cengizhantopcu53/hava_kalitesi_olcumu/Source/additional/hava_kalitesi_olcumu_sensor.xlsx

Sheet: SO2
SO2
Üretici | Sensör | Çıkış | Sıcaklık | Voltaj | Akım | Ölçüm | Basınç | Fiyat | Link
Kemet | USEQGCCAS82100 | Analog | -40°C - 85°C | 2.7V - 8V | - | 7.30µm / (200nm) | - | $99 | https://www.digikey.com/en/products/detail/kemet/USEQGCCAS82100/11503859
 | USEQGCDAS82100 | Analog | -40°C - 85°C | 2.7V - 8V | - | 7.30µm / (200nm) | - | $171 | https://www.digikey.com/en/products/detail/kemet/USEQGCDAS82100/12501736
SGX | EC4-20-SO2 | Voltaj | -20°C - 40°C | - | - | 0-20 ppm | 90-110 kP | $157 | https://www.digikey.com/en/products/detail/amphenol-sgx-sensortech/EC4-20-SO2/10270048
 | EC4-2000-SO2 | Voltaj | -20°C - 50°C | - | - | 0-2000 ppm | 90-110 kP | $134 | https://tr.farnell.com/amphenol-sgx-sensortech/ec4-2000-so2/industrial-sensor-so2-2000ppm/dp/3523152
 | PS1-SO2-50 | Voltaj | -40°C - 55°C | - | - | 0-50 ppm | 800 to 1200 hPA | $75 | https://www.mouser.com.tr/ProductDetail/Amphenol-SGX-Sensortech/PS1-SO2-50?qs=vvQtp7zwQdPTUdx7W%2F6Zdg%3D%3D
 | PS4-SO2-50 | Voltaj | -40°C - 55°C | - | - | 0-50 ppm | 800 to 1200 hPA | $142 | https://www.mouser.com.tr/ProductDetail/Amphenol-SGX-Sensortech/PS4-SO2-50?qs=vvQtp7zwQdOwl2xQY7f%2F%2Fw%3D%3D
 | SGX-4SO2 | Akım | -30°C - 50°C | 0.75V | 0.1 mA | 0-20 ppm | 800-1200 mbar | $95 | https://www.digikey.com/en/products/detail/amphenol-sgx-sensortech/SGX-4SO2/15816416
 | SGX-7SO2 | Akım | -30°C - 50°C | 0.75V | 0.1 mA | 0-100 ppm | 800-1200 mbar | $102 | https://www.digikey.com/en/products/detail/amphenol-sgx-sensortech/SGX-7SO2/15816406

Sheet: NO2
NO2
Üretici | Sensör | Çıkış | Sıcaklık | Voltaj | Akım | Ölçüm | Basınç | Fiyat | Link
Kemet | USEQGCDAN82100 | Analog | -40°C - 85°C | 2.7V - 8V | - | 6.20µm / (200nm) | - | $154 | https://www.digikey.com/en/products/detail/kemet/USEQGCDAN82100/12501745
SGX | EC4-20-NO2 | Voltaj | -20°C - 50°C | - | 0.4 µA | 0-20 ppm | 90-110 kPa | $159 | https://tr.farnell.com/amphenol-sgx-sensortech/ec4-20-no2/industrial-sensor-no2-20ppm-th/dp/3513412
 | PS1-NO2-50 | Voltaj | -40°C - 55°C | - | - | 0-50 ppm | 800-1200 kPa | $75 | https://www.digikey.com/en/products/detail/amphenol-sgx-sensortech/PS1-NO2-50/16634072
 | PS4-NO2-50 | Voltaj | -40°C - 55°C | - | - | 0-50 ppm | 800-1200 kPa | $142 | https://www.digikey.com/en/products/detail/amphenol-sgx-sensortech/PS4-NO2-50/16634084
 | MICS-2714 | Voltaj | -30°C - 85°C | 4.9V - 5.1V | 26 mA | 0.05-10 ppm | - | $11 | https://www.digikey.com/en/products/detail/amphenol-sgx-sensortech/MICS-2714/15816394
 | MICS-4514 | Voltaj | -30°C - 85°C | 4.9V - 5.1V | 26 mA | 0.05-10 ppm | - | $11 | https://www.digikey.com/en/products/detail/amphenol-sgx-sensortech/MICS-4514/15816409
 | SGX-7NO2 | Akım | -30°C - 50°C | 1.3 V | 0.3 mA | 0-20 ppm | 800 to 1200 mbar | $95 | https://www.digikey.com/en/products/detail/amphenol-sgx-sensortech/SGX-7NO2/15816354
 | SGX-4NO2 | Akım | -30°C - 50°C | 1.3 V | 0.3 mA | 0-20 ppm | 800 to 1200 mbar | $49 | https://www.digikey.com/en/products/detail/amphenol-sgx-sensortech/SGX-4NO2/15816430
 | SGX-4NO2-2E | Akım | -30°C - 50°C | 1.3 V | 0.3 mA | 0-20 ppm | 800 to 1200 mbar | $49 | https://www.digikey.com/en/products/detail/amphenol-sgx-sensortech/SGX-4NO2-2E/15816361

Sheet: CO
CO
Üretici | Sensör | Çıkış | Sıcaklık | Voltaj | Akım | Ölçüm | Basınç | Fiyat | Link
Kemet | USEQGCCAC8L100 | Analog | -40°C - 85°C | 2.7V - 8V | - | 4.64µm / (180nm) | - | $77 | https://www.digikey.com/en/products/detail/kemet/USEQGCCAC8L100/11503889
 | USEQGCCAC8N100 | Analog | -40°C - 85°C | 2.7V - 8V | - | 4.64µm / (90nm) | - | $77 | https://www.mouser.com.tr/ProductDetail/KEMET/USEQGCCAC8N100?qs=xZ%2FP%252Ba9zWqaz%252Bpt9JkTjvQ%3D%3D
 | USEQGCDAC8L100 | Analog | -40°C - 85°C | 2.7V - 8V | - | 4.64µm / (180nm) | - | $97 | https://www.digikey.com/en/products/detail/kemet/USEQGCDAC8L100/12501732
 | USEQGCDAC8N100 | Analog | -40°C - 85°C | 2.7V - 8V | - | 4.64µm / (90nm) | - | $97 | https://www.digikey.com/en/products/detail/kemet/USEQGCDAC8N100/12501743
SGX | EC4-500-CO | Voltaj | -20°C - 50°C | - | - | 0-500 ppm | 90-110 kPa | $98 | https://www.mouser.com.tr/ProductDetail/Amphenol-SGX-Sensortech/EC4-500-CO?qs=0lSvoLzn4L9J%2FbV1Ld8fdw%3D%3D
 | EC4-2000-CO | Voltaj | -20°C - 50°C | - | - | 0-2000 ppm | 90-110 kPa | $82 | https://tr.farnell.com/amphenol-sgx-sensortech/ec4-2000-co/electrochemical-sensor-co-2000ppm/dp/3513416
 | PS1-CO-100 | Voltaj | -40°C - 55°C | - | - | 0-100 ppm | 80-120 kPa | $58 | https://www.digikey.com/en/products/detail/amphenol-sgx-sensortech/PS1-CO-100/16634088
 | PS4-CO-100 | Voltaj | -40°C - 55°C | - | - | 0-100 ppm | 80-120 kPa | $116 | https://www.mouser.com.tr/ProductDetail/Amphenol-SGX-Sensortech/PS4-CO-100?qs=vvQtp7zwQdPEGqOtAoKNiQ%3D%3D
 | PS1-CO-1000 | Voltaj | -40°C - 55°C | - | - | 0-1000 ppm | 80-120 kPa | $45 | https://www.digikey.com/en/products/detail/amphenol-sgx-sensortech/PS1-CO-1000/16634062
 | PS4-CO-1000 | Voltaj | -40°C - 55°C | - | - | 0-1000 ppm | 80-120 kPa | $95 | https://www.mouser.com.tr/ProductDetail/Amphenol-SGX-Sensortech/PS4-CO-1000?qs=vvQtp7zwQdOtSaOt6WSp0g%3D%3D
 | MICS-4514 | Voltaj | -30°C - 85°C | 4.9V- 5.1V | 32 mA | 1-1000 ppm | - | $11 | https://www.mouser.com.tr/ProductDetail/Amphenol-SGX-Sensortech/MICS-4514?qs=YCa%2FAAYMW0137ZWFFytKcQ%3D%3D
 | MICS-6814 | Voltaj | -30°C - 85°C | 4.9V- 5.1V | 32 mA | 1-1000 ppm | - | $12 | https://www.mouser.com.tr/ProductDetail/Amphenol-SGX-Sensortech/MICS-6814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
 | SGX-4CO | Akım | -30°C - 50°C | 1.3 V | 0.3 mA | 0-2000 ppm | 80-120 kPa | $57 | https://www.mouser.com.tr/ProductDetail/Amphenol-SGX-Sensortech/SGX-4CO?qs=0lSvoLzn4L8LQtm7CTs3vQ%3D%3D
 | SGX-4CO-10K | Akım | -30°C - 50°C | 1.3 V | 0.3 mA | 0-10000 ppm | 80-120 kPa | $83 | https://www.mouser.com.tr/ProductDetail/Amphenol-SGX-Sensortech/SGX-4CO-10K?qs=GedFDFLaBXFmrQMDUzumOA%3D%3D
 | SGX-4CO-LC | Akım | -30°C - 50°C | 1.3 V | 0.3 mA | 0-1000 ppm | 80-120 kPa | $44 | https://www.mouser.com.tr/ProductDetail/Amphenol-SGX-Sensortech/SGX-4CO-LC?qs=GedFDFLaBXE0aGXFPNJr4w%3D%3D
 | SGX-7CO | Akım | -30°C - 50°C | 1.3 V | 0.3 mA | 0-1000 ppm | 80-120 kPa | $72 | https://www.mouser.com.tr/ProductDetail/Amphenol-SGX-Sensortech/SGX-7CO?qs=0lSvoLzn4L%2FBSLxNkV0k2w%3D%3D
Broadcam | AFBR-S6PY0211 | Voltaj | -40°C - 85°C | 2.7V - 8V | - | 4.64µm / (180nm) | - | $75 | https://tr.farnell.com/broadcom/afbr-s6py0211/gas-sensor-1-ch-analogue-to-39/dp/4060251

Sheet: CO2
CO2
Üretici | Sensör | Çıkış | Sıcaklık | Voltaj | Akım | Ölçüm (ppm) | Basınç (kPa) | Fiyat | Link
Kemet | USEQGCCAC82L00 | Analog | -40°C - 85°C | 2.7V - 8V | - | 4.26µm / (180nm) | - | $77 | https://www.digikey.com/en/products/detail/kemet/USEQGCCAC82L00/11503841
 | USEQGCCAC82S00 | Analog | -40°C - 85°C | 2.7V - 8V | - | 4.43µm / (60nm) | - | $77 | https://www.mouser.com.tr/ProductDetail/KEMET/USEQGCCAC82S00?qs=xZ%2FP%252Ba9zWqYSOr2sr9i6xA%3D%3D
 | USEQGCCAC82N00 | Analog | -40°C - 85°C | 2.7V - 8V | - | 4.30µm / (110nm) | - | $77 | https://www.mouser.com.tr/ProductDetail/KEMET/USEQGCCAC82N00?qs=xZ%2FP%252Ba9zWqa0zODrlCBrCg%3D%3D
 | USEQGCDAC82L00 | Analog | -40°C - 85°C | 2.7V - 8V | - | 4.26µm / (180nm) | - | $89 | https://www.digikey.com/en/products/detail/kemet/USEQGCDAC82L00/12501729
 | USEQGCDAC82S00 | Analog | -40°C - 85°C | 2.7V - 8V | - | 4.43µm / (60nm) | - | $97 | https://www.digikey.com/en/products/detail/kemet/USEQGCDAC82S00/12501728
 | USEQGCDAC82N00 | Analog | -40°C - 85°C | 2.7V - 8V | - | 4.30µm / (110nm) | - | $97 | https://www.mouser.com.tr/ProductDetail/KEMET/USEQGCDAC82N00?qs=xZ%2FP%252Ba9zWqZG3G1897dohg%3D%3D
 | USEQGCDAC82M00 | Analog | -40°C - 85°C | 2.7V - 8V | - | 4.26µm / (180nm) | - | $89 | https://www.mouser.com.tr/ProductDetail/KEMET/USEQGCDAC82M00?qs=xZ%2FP%252Ba9zWqZhxqSk2f0j7w%3D%3D
 | USEQGCDAC82100 | Analog | -40°C - 85°C | 2.7V - 8V | - | 4.26µm / (180nm) | - | $89 | https://www.mouser.com.tr/ProductDetail/KEMET/USEQGCDAC82100?qs=xZ%2FP%252Ba9zWqYWrD6P3FWZRg%3D%3D
 | USEQGCQAC82H00 | Analog | -40°C - 85°C | 2.7V - 8V | - | 4.64µm / (180nm) | - | $334 | https://www.mouser.com.tr/ProductDetail/KEMET/USEQGCQAC82H00?qs=xZ%2FP%252Ba9zWqaJ1lQqwZ%252BdrA%3D%3D
 | USEQGSEAC82180 | I2C | -40°C - 85°C | 2.7V - 8V | 22 μA | 4.26µm / (180nm) | - | $26 | https://tr.farnell.com/kemet/useqgseac82180/ir-gas-detector-sensor-serial/dp/3489508
SGX | IR11EJ | Voltaj | -20°C - 50°C | 3V - 5V | 60 mA | - | 30-130 kPa | $225 | https://www.digikey.com/en/products/detail/amphenol-sgx-sensortech/IR11EJ/7102251
 | IR15TT | Voltaj | -20°C - 50°C | 3V - 5V | 60 mA | - | 30-130 kPa | $324 | https://www.mouser.com.tr/ProductDetail/Amphenol-SGX-Sensortech/IR15TT?qs=Ey4jopcCj2pjqPmpKnx20Q%3D%3D
 | IR21EJ | Voltaj | -20°C - 50°C | 3V - 5V | 60 mA | - | 30-130 kPa | $221 | https://www.mouser.com.tr/ProductDetail/Amphenol-SGX-Sensortech/IR21EJ?qs=Ey4jopcCj2rE4g560nDbjQ%3D%3D
 | IR25TT-M | Voltaj | -20°C - 65°C | 3V - 5V | 60 mA | - | 30-130 kPa | $287 | https://www.mouser.com.tr/ProductDetail/Amphenol-SGX-Sensortech/IR25TT-M?qs=Ey4jopcCj2pVz5ny0M5jVw%3D%3D
 | IR31BC | Voltaj | -20°C - 50°C | 3V - 5V | 60 mA | - | 30-130 kPa | $317 | https://www.mouser.com.tr/ProductDetail/Amphenol-SGX-Sensortech/IR31BC?qs=Ey4jopcCj2r33TvfOva1PA%3D%3D
 | IR601/2 | Voltaj | -20°C - 65°C | 3V - 5V | 60 mA | - | 30-130 kPa | $468 | https://www.mouser.com.tr/ProductDetail/Amphenol-SGX-Sensortech/IR601-2?qs=Ey4jopcCj2r433gDDt8A5w%3D%3D
 | INIR-CD-5% | Voltaj | -20°C - 50°C | 3.2V - 5.25V | 35 mA | - | 80-120 kPa | $281 | https://www.mouser.com.tr/ProductDetail/Amphenol-SGX-Sensortech/INIR-CD-5?qs=Ey4jopcCj2qCHWdEnsJyOg%3D%3D
Broadcam | AFBR-S6PY0234 | Analog | -40°C - 85°C | 2.7V - 8V | - | 4.26µm / (180nm) | - | $63 | https://tr.farnell.com/broadcom/afbr-s6py0234/gas-sensor-2-ch-analogue-to-39/dp/4060268
 | AFBR-S6PY1943 | Analog | -40°C - 85°C | 2.7V - 8V | - | 4.30µm / (110nm) | - | $63 | https://tr.farnell.com/broadcom/afbr-s6py1943/gas-sensor-2-ch-analogue-to-39/dp/4060274
 | AFBR-S6PY2572 | Analog | -40°C - 85°C | 2.7V - 8V | - | 4.26µm / (180nm) | - | $63 | https://tr.farnell.com/broadcom/afbr-s6py2572/gas-sensor-2-ch-analogue-to-39/dp/4060277
 | AFBR-S6EPY12231R | I2C | -40°C - 85°C | 1.75 - 3.6 V | 22 μA | 4.26µm / (180nm) | - | $16 | https://tr.farnell.com/broadcom/afbr-s6epy12231r/gas-sensor-1-ch-digital-smd/dp/4060264
Sensirion | STC31-R1 | I2C | -20°C - 85°C | 2.7V - 5.5V | 70 mA | - | 800-1200 mbar | $68 | https://www.mouser.com.tr/ProductDetail/Sensirion/STC31-R1?qs=bAKSY%2FctAC4PFVBnFehkEg%3D%3D
 | STC31-R3 | I2C | -20°C - 85°C | 2.7V - 5.5V | 70 mA | - | 800-1200 mbar | $68 | https://www.mouser.com.tr/ProductDetail/Sensirion/STC31-R3?qs=bAKSY%2FctAC6ULsjdtfE3Ww%3D%3D
 | STC31-R5 | I2C | -20°C - 85°C | 2.7V - 5.5V | 70 mA | - | 800-1200 mbar | $43 | https://www.mouser.com.tr/ProductDetail/Sensirion/STC31-R5?qs=bAKSY%2FctAC7I27VugTJQDQ%3D%3D
 | SCD40-D-R1 | I2C | -20°C - 85°C | 2.7V - 5.5V | 205 mA | 400-2000 ppm | 800-1200 mbar | $39 | https://www.mouser.com.tr/ProductDetail/Sensirion/SCD40-D-R1?qs=HBWAp0VN4RjvSDpwiC%2F4pQ%3D%3D
 | SCD40-D-R2 | I2C | -20°C - 85°C | 2.7V - 5.5V | 205 mA | 400-2000 ppm | 800-1200 mbar | $30 | https://www.mouser.com.tr/ProductDetail/Sensirion/SCD40-D-R2?qs=HBWAp0VN4RjIKW%252BlMeZn1w%3D%3D
 | SCD41-D-R1 | I2C | -20°C - 85°C | 2.7V - 5.5V | 205 mA | 400-5000 ppm | 800-1200 mbar | $52 | https://www.mouser.com.tr/ProductDetail/Sensirion/SCD41-D-R1?qs=HBWAp0VN4Rg1hR6vTmplbw%3D%3D
 | SCD41-D-R2 | I2C | -20°C - 85°C | 2.7V - 5.5V | 205 mA | 400-5000 ppm | 800-1200 mbar | $52 | https://www.mouser.com.tr/ProductDetail/Sensirion/SCD41-D-R1?qs=HBWAp0VN4Rg1hR6vTmplbw%3D%3D
 | SCD42-D-R2 | I2C | 0°C - 50°C | 2.4V - 5.5V | 11 mA | 400-1000 ppm | 800-1200 mbar | $50 | https://www.mouser.com.tr/ProductDetail/Sensirion/SCD42-D-R2?qs=A6eO%252BMLsxmSRIzSbnJAIXA%3D%3D
Gas Sensing Solutions | EXPLORIR-M-20 | Uart | 0°C - 50°C | 3.25 - 5.5V | 1.5 mA | - | 500 mbar-10 bar | $210 | https://www.digikey.com/en/products/detail/gas-sensing-solutions-ltd/EXPLORIR-M-20/9952879
 | EXPLORIR-M-E-100 | Uart | 0°C - 50°C | 3.25 - 5.5V | 1.5 mA | - | 500 mbar-10 bar | $219 | https://www.digikey.com/en/products/detail/gas-sensing-solutions-ltd/EXPLORIR-M-E-100/13148762
 | COZIR-AH-E-1 | Uart | 0°C - 50°C | 3.25 - 5.5V | 1.5 mA | - | 500 mbar-10 bar | $154 | https://www.digikey.com/en/products/detail/gas-sensing-solutions-ltd/COZIR-AH-E-1/13148756
 | SPRINTIR-R-20 | Uart | 0°C - 50°C | 3.25 - 5.5V | 1.5 mA | - | 500 mbar-10 bar | $389 | https://www.digikey.com/en/products/detail/gas-sensing-solutions-ltd/SPRINTIR-R-20/13148759
