cengizhantopcu53/hava_kalitesi_olcumu/Docs/schema.pdf

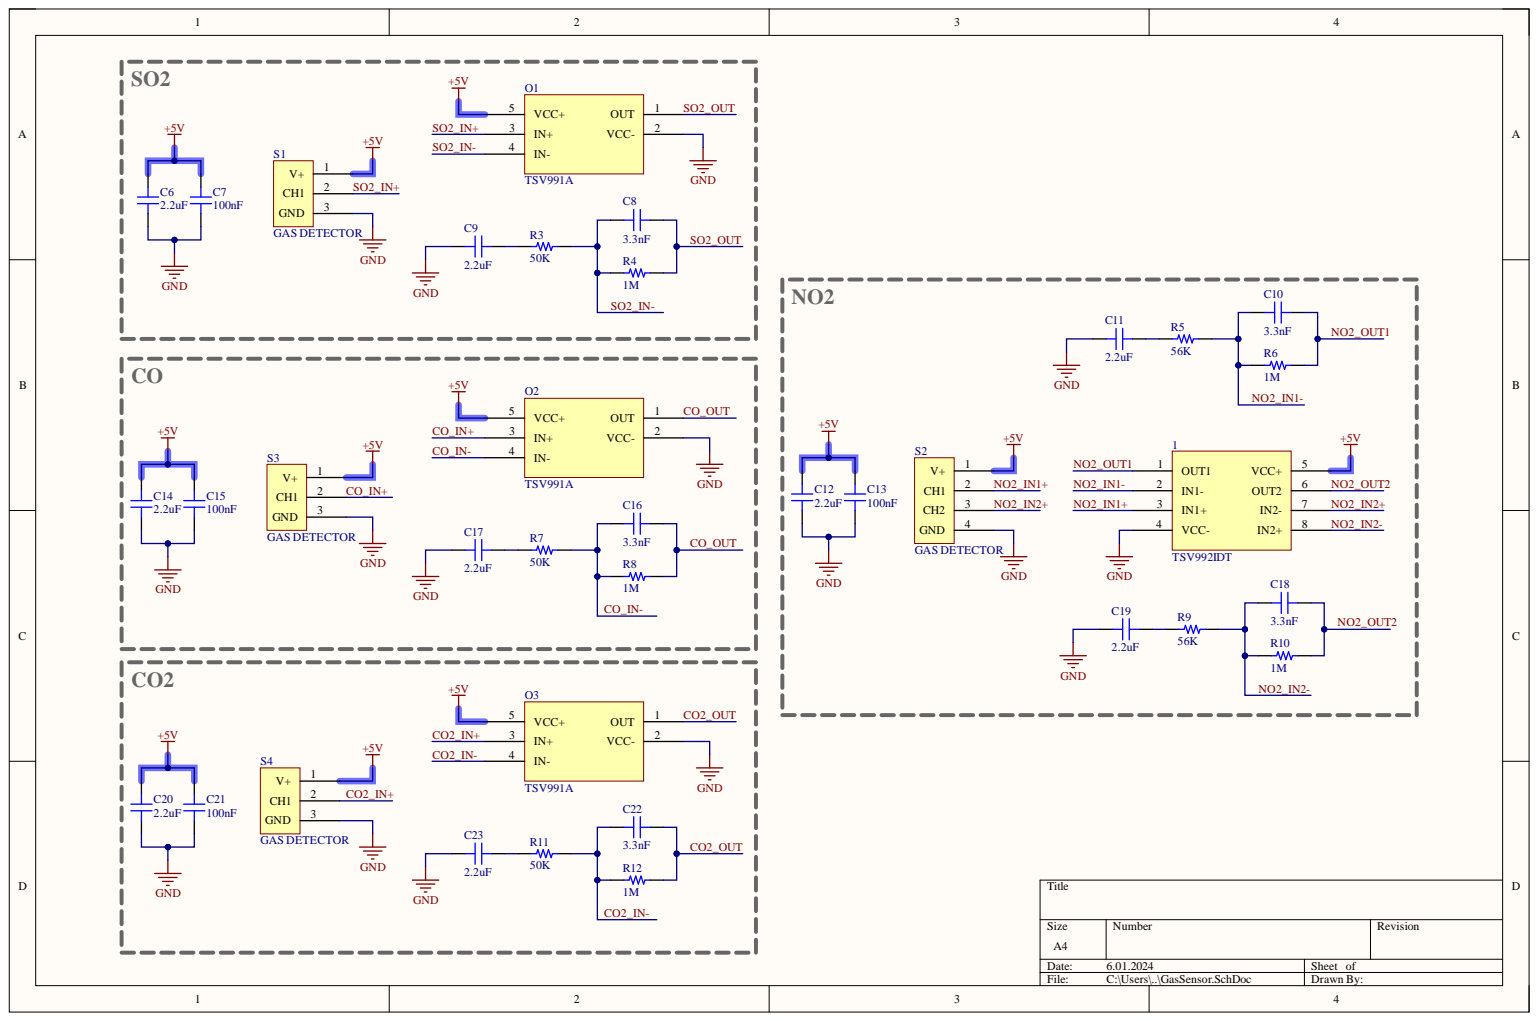
[picture p3: page 1]

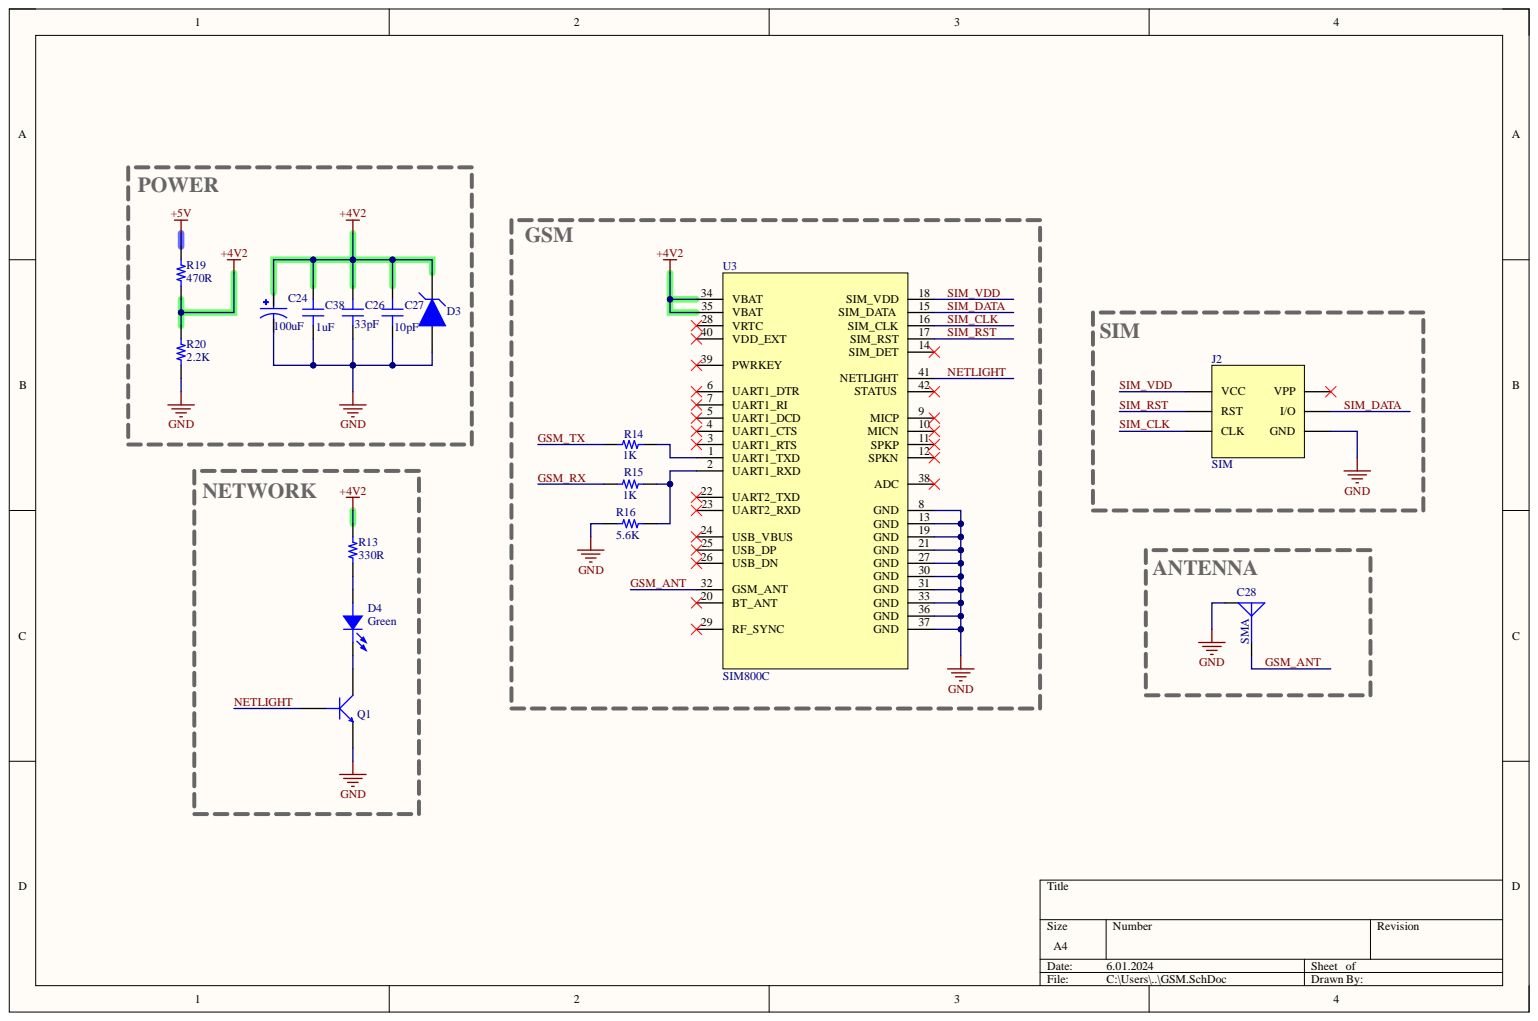
[picture p4: page 2]

3 6
3 7

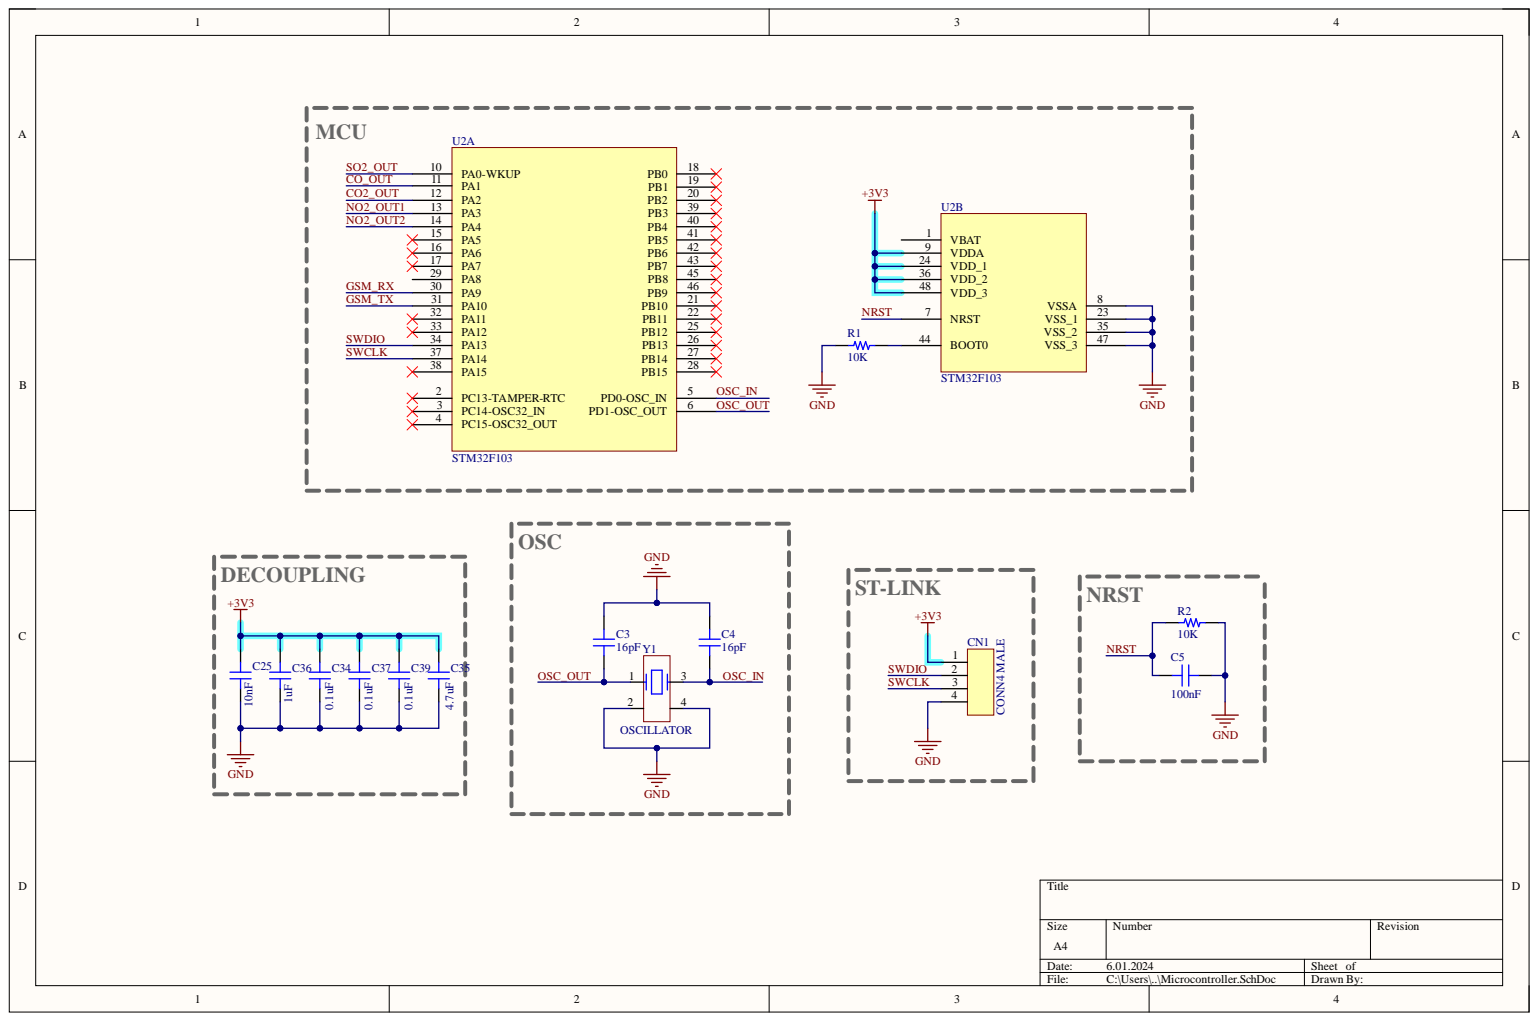
[picture p5: page 3]

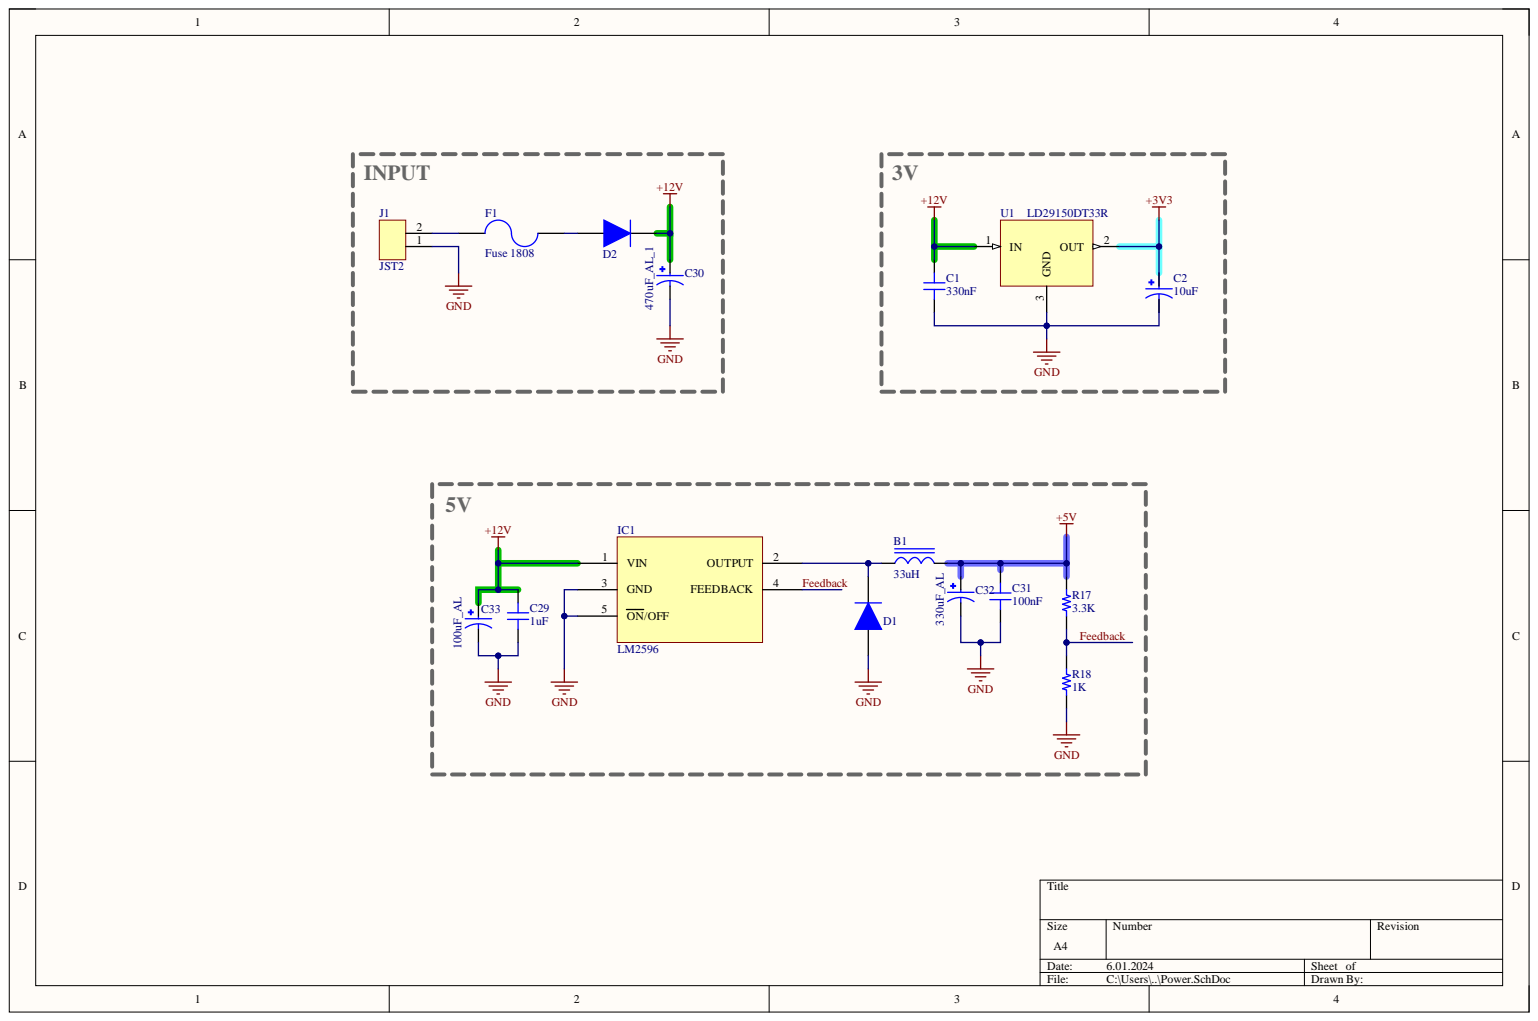
[picture p6: page 4]
