cengizhantopcu53/hava_kalitesi_olcumu/(list of files, drawings)

Other design files:
Hardware/GasSensor.SchDoc
Hardware/GSM.SchDoc
Hardware/hava_kalitesi_olcumu.PcbLib
Hardware/hava_kalitesi_olcumu.PrjPcb
Hardware/hava_kalitesi_olcumu.SchLib
Hardware/Microcontroller.SchDoc
Hardware/Power.SchDoc
